bjhling/30-1-Harmonic-Gearbox/0_25m Test Arm.STEP

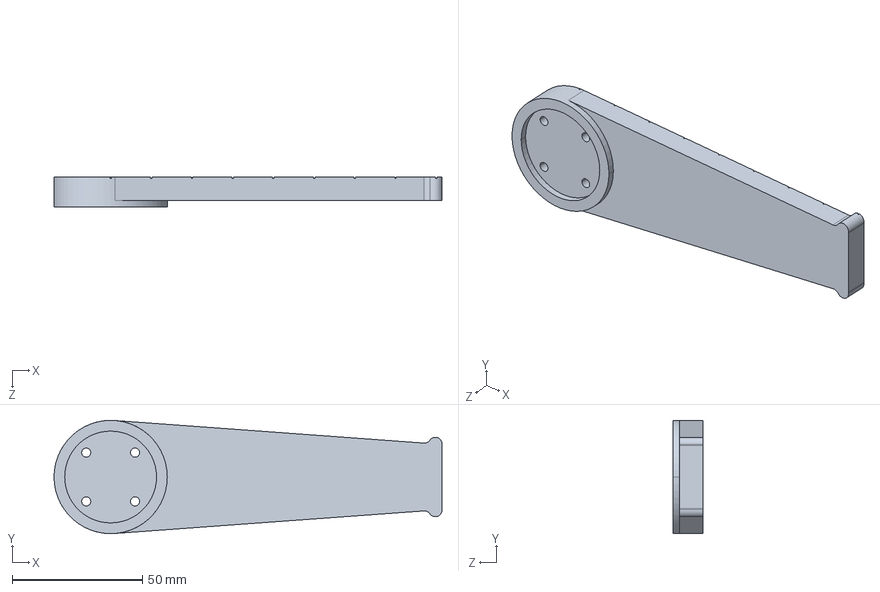
[picture p1: CAD file, 2025-01-29]
0_25m Test Arm.STEP
149.0 x 43.5 x 11.4 mm
