bjhling/30-1-Harmonic-Gearbox/Wave Generator REV2 Print Part.STEP

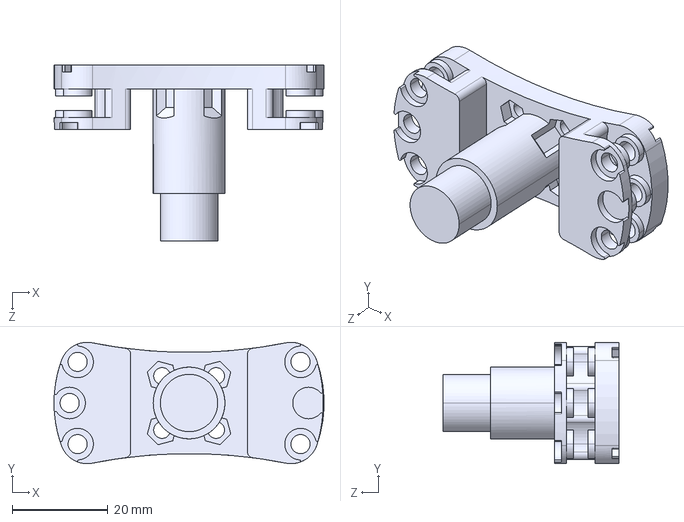
[picture p2: CAD file, 2025-01-29]
Wave Generator REV2 Print Part.STEP
56.5 x 25.4 x 36.9 mm
