bjhling/30-1-Harmonic-Gearbox/Flex Spline 2.STEP

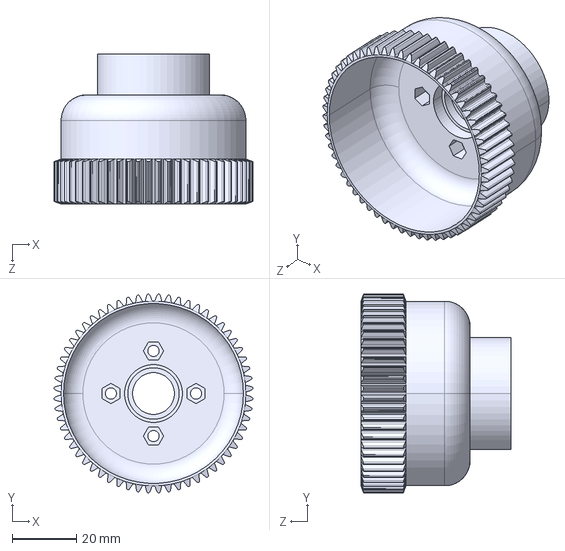
[picture p3: CAD file, 2025-01-29]
Flex Spline 2.STEP
61.9 x 61.9 x 46.7 mm
