bjhling/30-1-Harmonic-Gearbox/520 Motor Shaft Flange.STEP

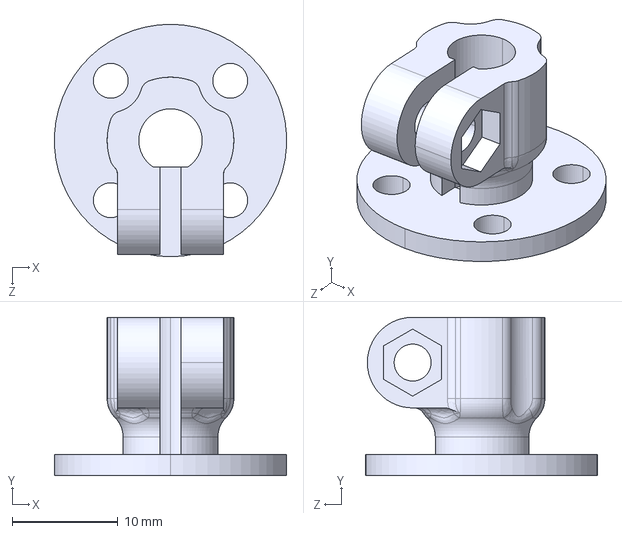
[picture p4: CAD file, 2025-01-29]
520 Motor Shaft Flange.STEP
22.0 x 15.0 x 22.0 mm
