bjhling/30-1-Harmonic-Gearbox/520 Motor Face Plate.STEP

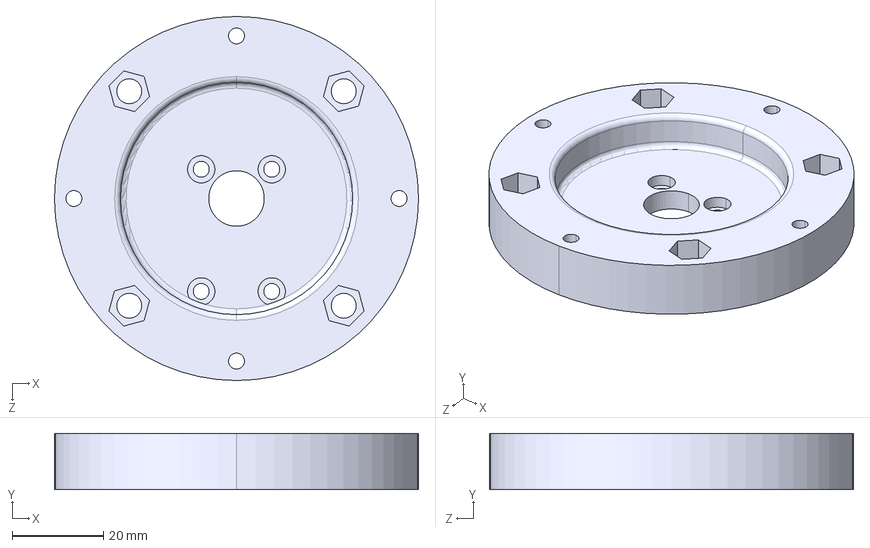
[picture p5: CAD file, 2025-01-29]
520 Motor Face Plate.STEP
80.0 x 12.4 x 80.0 mm
