bjhling/30-1-Harmonic-Gearbox/Outer Gear Housing.STEP

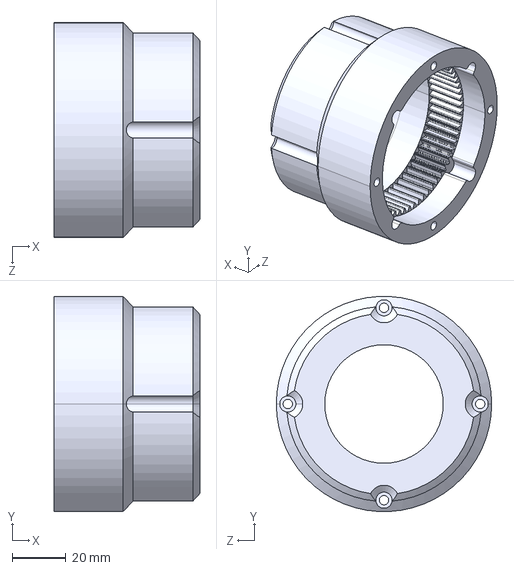
[picture p6: CAD file, 2025-01-29]
Outer Gear Housing.STEP
54.1 x 79.9 x 80.0 mm
