bjhling/30-1-Harmonic-Gearbox/Assembly Instruction for Harmonic Gearbox.pdf

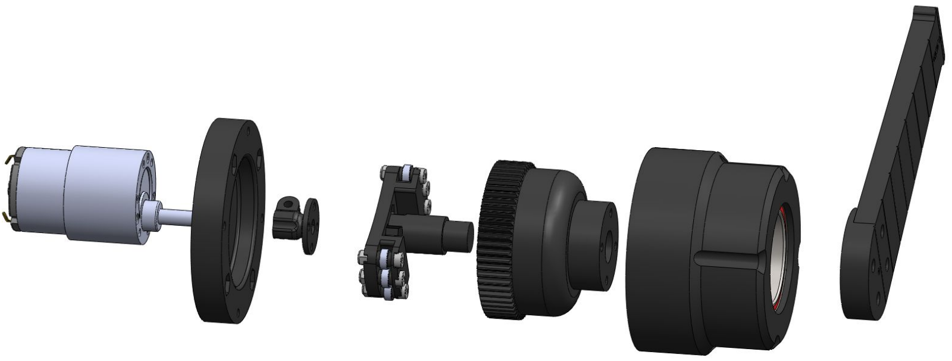
[picture p7: page 1]

2.

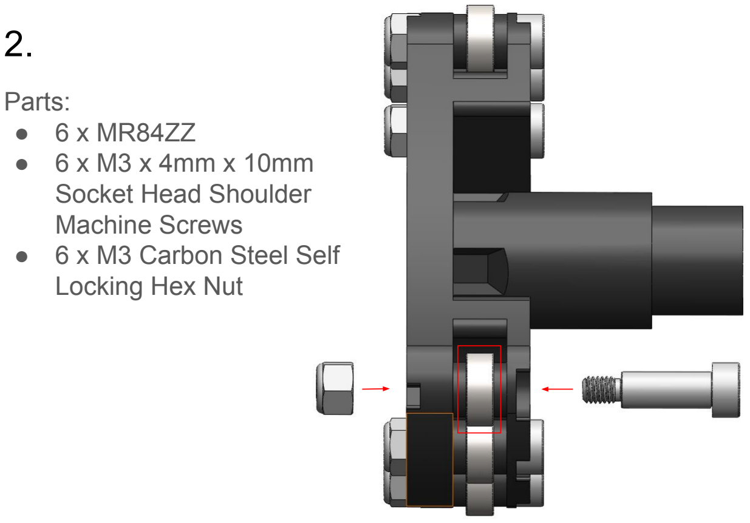
[picture p8: page 2]

Parts:
- 6 x MR84ZZ
- 6 x M3 x 4mm x 10mm
Socket Head Shoulder
Machine Screws
- 6 x M3 Carbon Steel Self Locking Hex Nut

3.

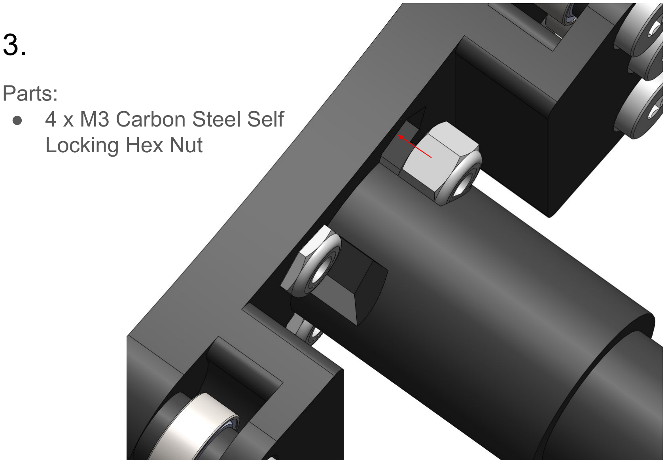
[picture p9: page 3]

Parts: ● 4 x M3 Carbon Steel Self Locking Hex Nut

4.

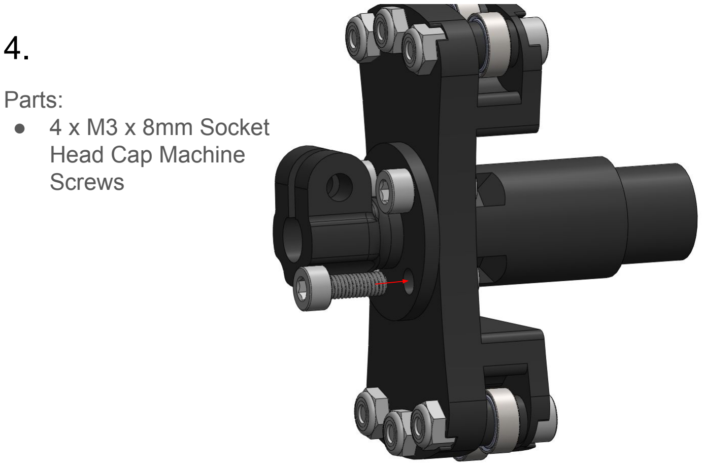
[picture p10: page 4]

Parts:
- 4 x M3 x 8mm Socket
Head Cap Machine
Screws

5.

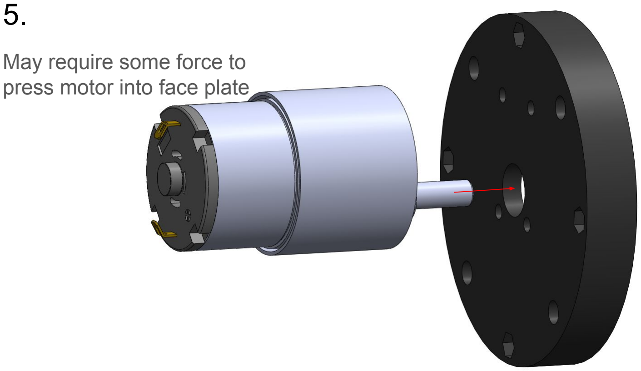
[picture p11: page 5]

May require some force to press motor into face plate

6.

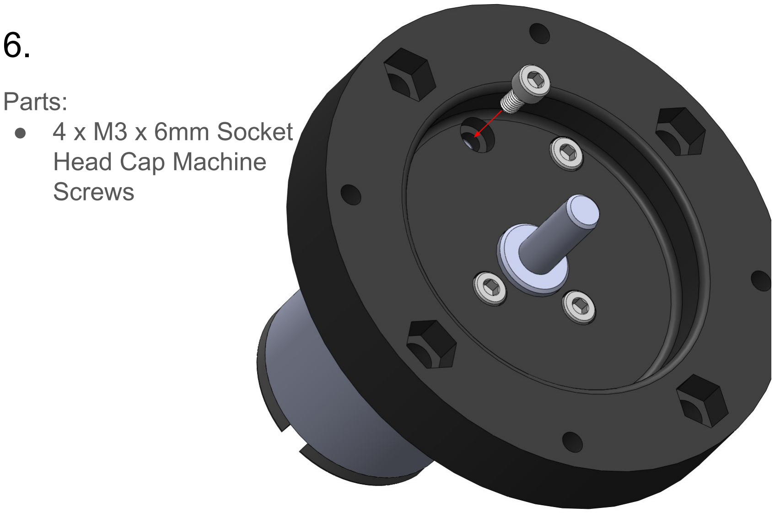
[picture p12: page 6]

Parts:
- 4 x M3 x 6mm Socket
Head Cap Machine
Screws

7.

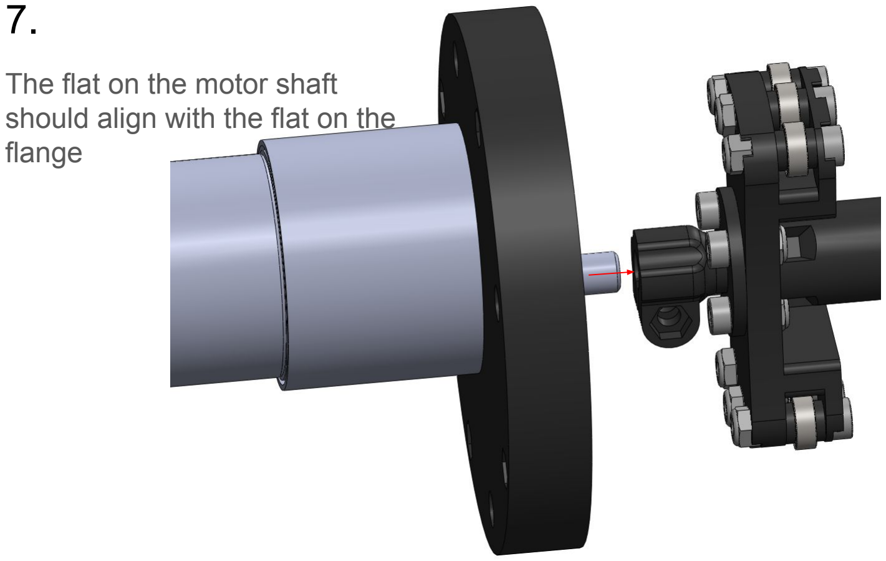
[picture p13: page 7]

The flat on the motor shaft should align with the flat on the flange

8.

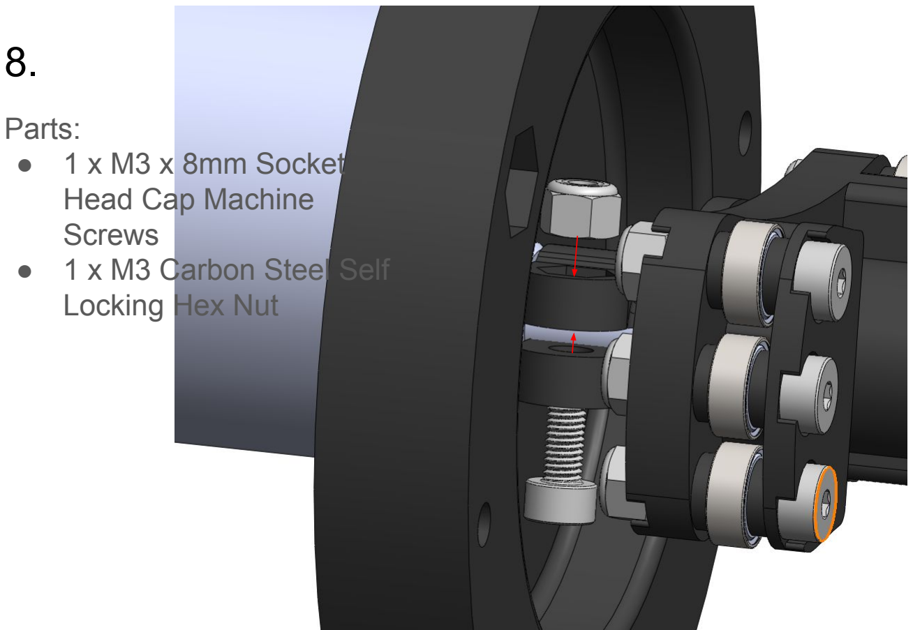
[picture p14: page 8]

Parts:
- 1 x M3 x 8mm Socket
Head Cap Machine
Screws
- 1 x M3 Carbon Steel Self Locking Hex Nut

9.

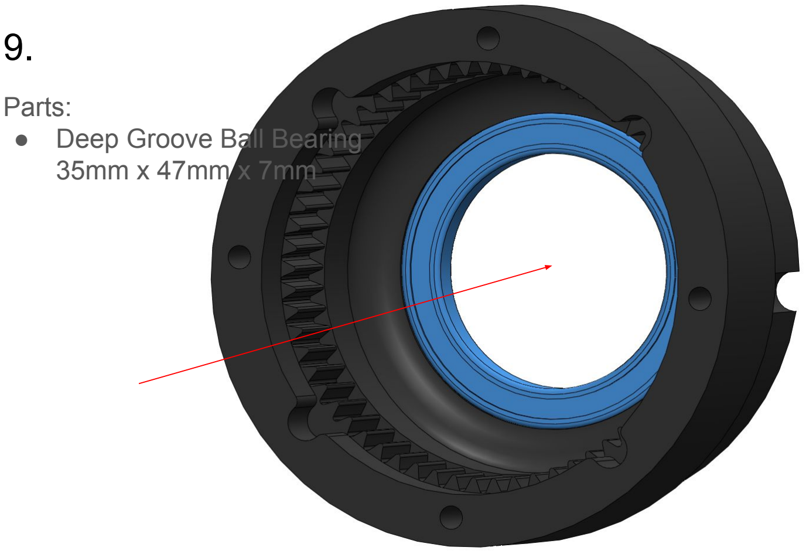
[picture p15: page 9]

Parts: ● Deep Groove Ball Bearing 35mm x 47mm x 7mm

10.

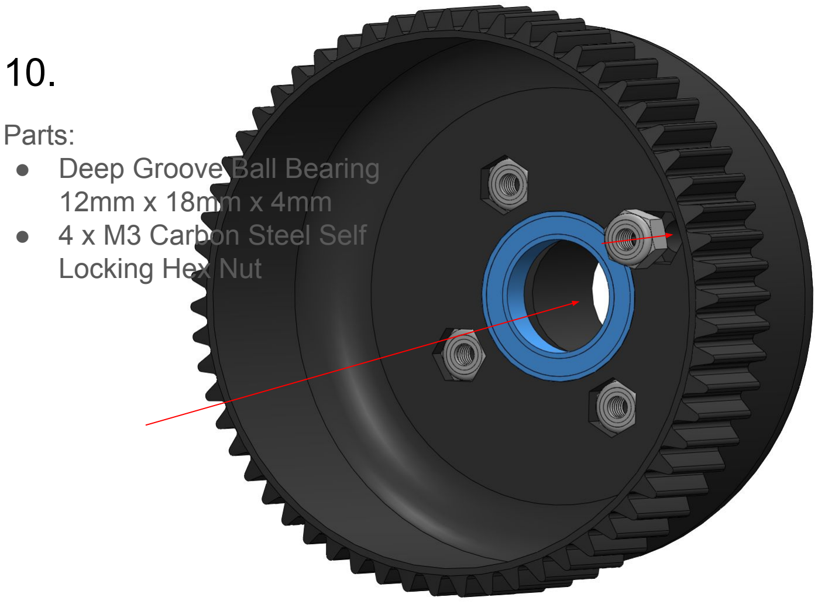
[picture p16: page 10]

Parts:
- Deep Groove Ball Bearing 12mm x 18mm x 4mm
- 4 x M3 Carbon Steel Self Locking Hex Nut

11.

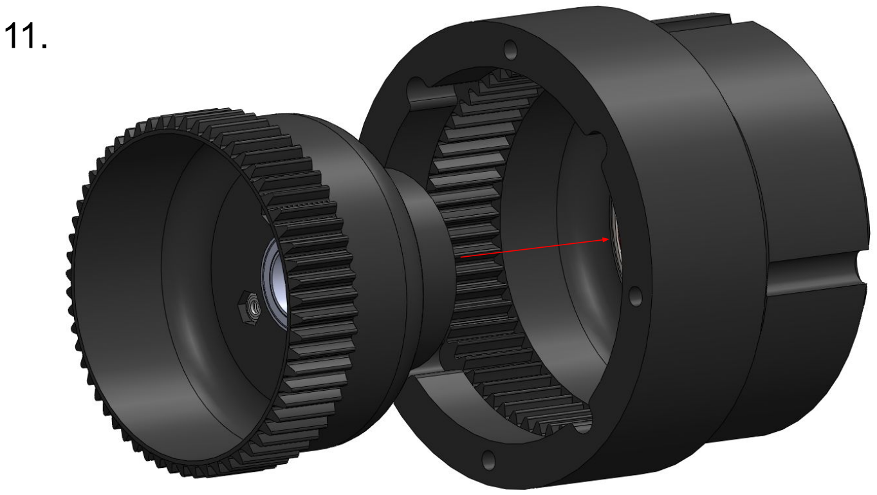
[picture p17: page 11]

12.

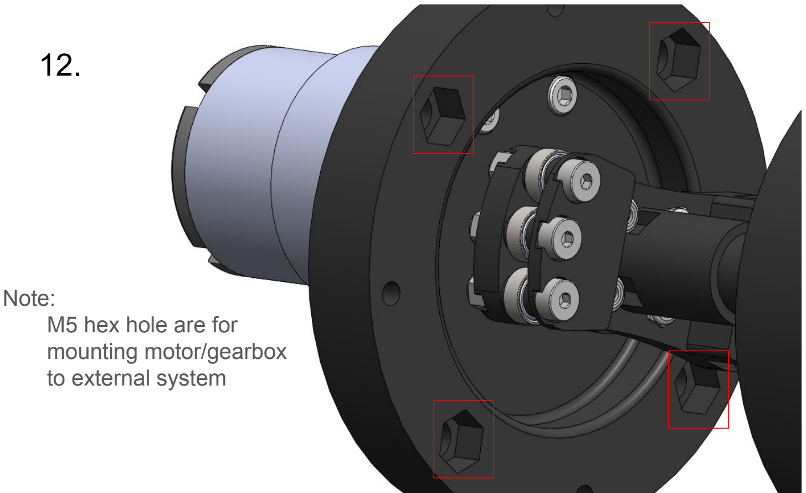
[picture p18: page 12]

Note:
M5 hex hole are for
mounting motor/gearbox
to external system

13.

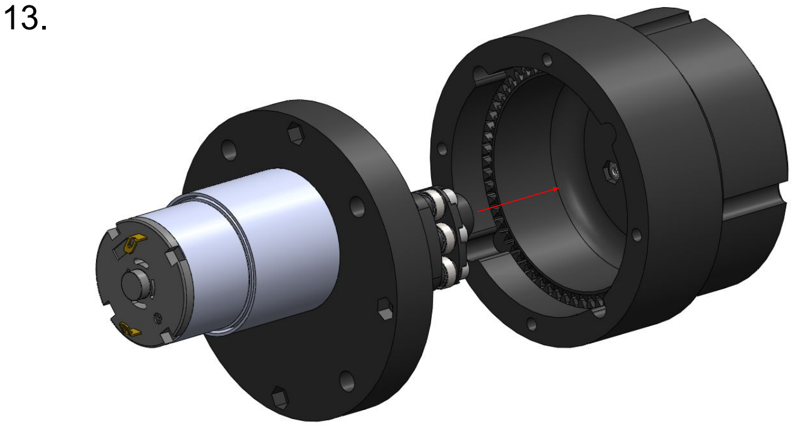
[picture p19: page 13]

14.

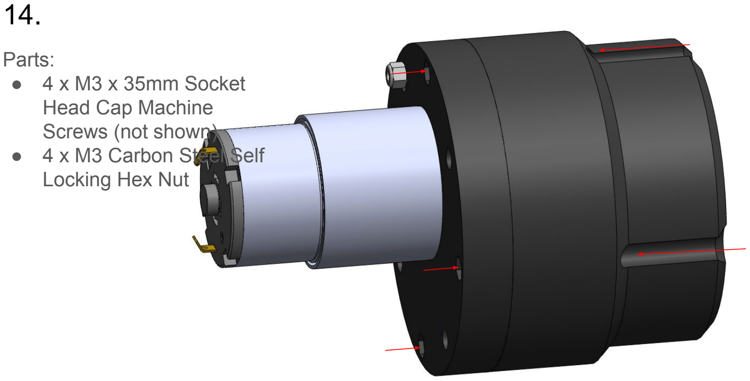
[picture p20: page 14]

Parts:
- 4 x M3 x 35mm Socket
Head Cap Machine
Screws (not shown)
- 4 x M3 Carbon Steel Self Locking Hex Nut
